happyMediumStl/SparrowAprs/README.md

# SparrowAprs
An open source APRS beacon designed for high altitude balloons

Code is a bit of a mess, and this is a work in progress, but it does sucessfully transmit APRS packets
