happyMediumStl/SparrowAprs/Hardware/README.md

#SparrowAprs Hardware

Controlled impedance traces designed for 4 layer stackup at Oshpark.
