happyMediumStl/SparrowAprs/Hardware/SparrowAprsArt.brd

## EAGLE design Hardware/SparrowAprsArt.brd (2018-09-21)

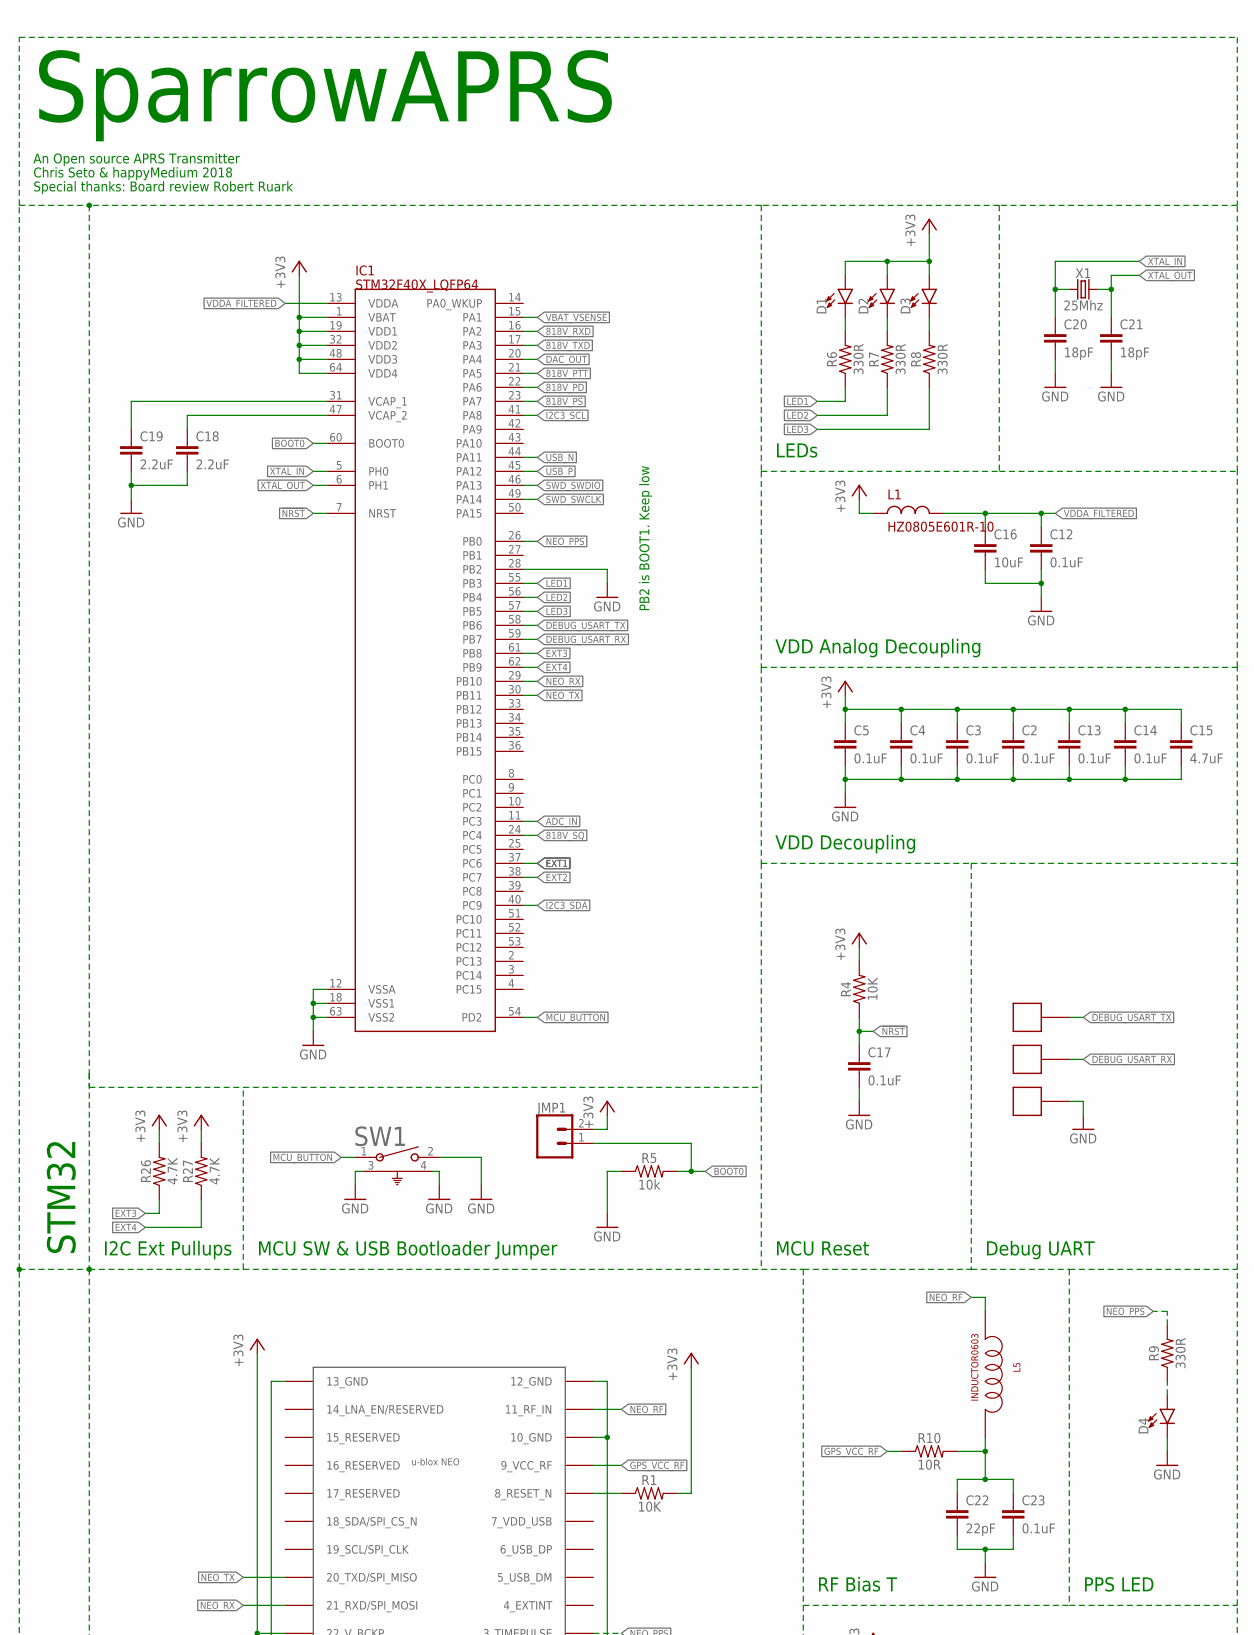
[picture p1: schematic SparrowAprsArt.sch, part in row 1, column 1]

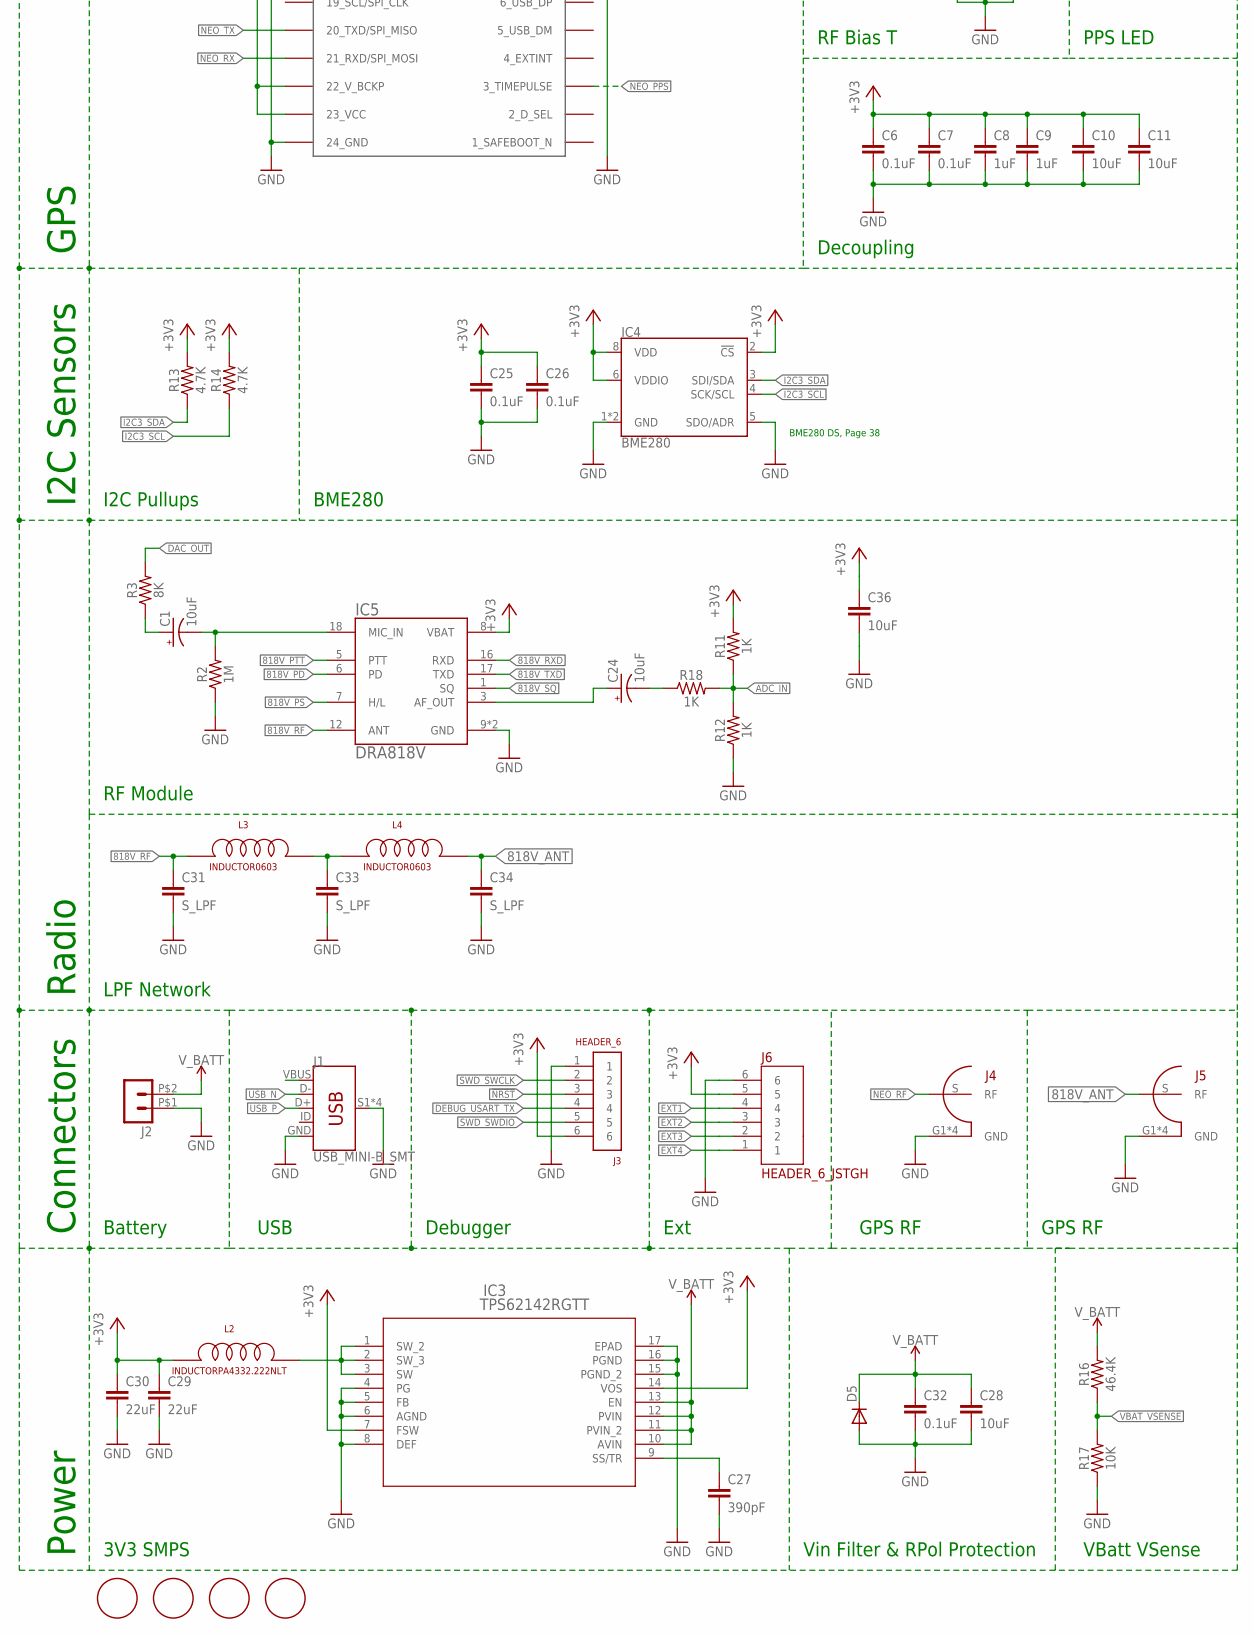
[picture p2: schematic SparrowAprsArt.sch, part in row 2, column 1]

Parts:
C1, C24: 10uF; 1206
C2, C3, C4, C5, C6, C7, C12, C13, C14, C17, C23, C25, C26, C32: 0.1uF; 0603
C8, C9: 1uF; C0805
C10, C11, C16, C28, C36: 10uF; C0805
C15: 4.7uF; C0805
C18, C19: 2.2uF; C0805
C20, C21: 18pF; 0603
C22: 22pF; 0603
C27: 390pF; 0603
C29, C30: 22uF; 1210
C31, C33, C34: S_LPF; 0603
D1, D2, D3, D4: LED0603; LED-0603
D5: DIODE-DO214AC; DO214AC
IC1: STM32F40X_LQFP64; STM32_LQFP64
IC2: NEO-M8
IC3: TPS62142RGTT; RGT16_1P7X1P7
IC4: BME280; LGA-8-2.5X2.5
IC5: DRA818V; DORJI_DRA818V
J1: USB_MINI-B_SMT; USB-MINIB
J2: HEADER_POS2_43650-0200; 43650-0200
J3: HEADER_6; 6X2_SMT
J4, J5: FSK_RUARK2_SMA_0732511150; FSK_RUARK2_WIDE_SMA
J6: HEADER_6_JSTGH; BM06B-GHS-TBT(LF)(SN)(N)
JMP1: CONN_02; 1X02
L1: HZ0805E601R-10; R0805
L2: INDUCTORPA4332.222NLT; PA4332.222NLT
L3, L4, L5: INDUCTOR0603; 0603
R1, R4, R17: 10K; 0603
R2: 1M; 0603
R3: 8K; 0603
R5: 10k; 0603
R6, R7, R8, R9: 330R; 0603
R10: 10R; 0603
R11, R12, R18: 1K; 0603
R13, R14, R26, R27: 4.7K; 0603
R16: 46.4K; 0603
SW1: 1825027-8; SW2_1825027-C
U$2, U$3, U$4: SINGLEPADMIDPAD; MIDPAD
U$7, U$8, U$9, U$10: MOUNTING_HOLE#2; #2_CLEARANCE_HOLE
X1: 25Mhz; CRYSTAL-SMD-3.2X2.5MM

Connections:
818V_ANT: C34.1, J5.S (RF), L4.2
818V_PD: IC1.22 (PA6), IC5.6 (PD)
818V_PS: IC1.23 (PA7), IC5.7 (H/L)
818V_PTT: IC1.21 (PA5), IC5.5 (PTT)
818V_RF: C31.1, IC5.12 (ANT), L3.1
818V_RXD: IC1.16 (PA2), IC5.16 (RXD)
818V_SQ: IC1.24 (PC4), IC5.1 (SQ)
818V_TXD: IC1.17 (PA3), IC5.17 (TXD)
!NRST: C17.1, IC1.7 (NRST), J3.3, R4.1
+3V3: C2.1, C3.1, C4.1, C5.1, C6.1, C7.1, C8.1, C9.1, C10.1, C11.1, C13.1, C14.1, C15.1, C25.1, C26.1, C29.1, C30.1, C36.1, D1.A, D2.A, D3.A, IC1.1 (VBAT), IC1.19 (VDD1), IC1.32 (VDD2), IC1.48 (VDD3), IC1.64 (VDD4), IC2.22 (22_V_BCKP), IC2.23 (23_VCC), IC3.7 (FSW), IC3.14 (VOS), IC4.2 (!CS), IC4.6 (VDDIO), IC4.8 (VDD), IC5.8 (VBAT), J3.6, J6.5, JMP1.2, L1.1, L2.1, R1.2, R4.2, R11.2, R13.2, R14.2, R26.2, R27.2
ADC_IN: IC1.11 (PC3), R11.1, R12.2, R18.2
BOOT0: IC1.60 (BOOT0), JMP1.1, R5.2
DAC_OUT: IC1.20 (PA4), R3.2
DEBUG_USART_RX: IC1.59 (PB7), U$3.1
DEBUG_USART_TX: IC1.58 (PB6), J3.4, U$2.1
EXT1: IC1.37 (PC6), J6.4
EXT2: IC1.38 (PC7), J6.3
EXT3: IC1.61 (PB8), J6.2, R26.1
EXT4: IC1.62 (PB9), J6.1, R27.1
GND: C2.2, C3.2, C4.2, C5.2, C6.2, C7.2, C8.2, C9.2, C10.2, C11.2, C12.2, C13.2, C14.2, C15.2, C16.2, C17.2, C18.2, C19.2, C20.2, C21.2, C22.2, C23.2, C25.2, C26.2, C27.2, C28.2, C29.2, C30.2, C31.2, C32.2, C33.2, C34.2, C36.2, D4.C, D5.A, IC1.12 (VSSA), IC1.18 (VSS1), IC1.28 (PB2), IC1.63 (VSS2), IC2.10 (10_GND), IC2.12 (12_GND), IC2.13 (13_GND), IC2.24 (24_GND), IC3.4 (PG), IC3.5 (FB), IC3.6 (AGND), IC3.8 (DEF), IC3.15 (PGND_2), IC3.16 (PGND), IC3.17 (EPAD), IC4.1 (GND), IC4.5 (SDO/ADR), IC4.7 (GND), IC5.9 (GND), IC5.10 (GND), J1.GND, J1.S1 (SHIELD), J1.S2 (SHIELD), J1.S3 (SHIELD), J1.S4 (SHIELD), J2.P$1 (1), J3.1, J4.G1 (GND), J4.G2 (GND), J4.G3 (GND), J4.G4 (GND), J5.G1 (GND), J5.G2 (GND), J5.G3 (GND), J5.G4 (GND), J6.6, R2.1, R5.1, R12.1, R17.1, SW1.2, SW1.3, SW1.4, U$4.1
GPS_VCC_RF: IC2.9 (9_VCC_RF), R10.1
I2C3_SCL: IC1.41 (PA8), IC4.4 (SCK/SCL), R14.1
I2C3_SDA: IC1.40 (PC9), IC4.3 (SDI/SDA), R13.1
LED1: IC1.55 (PB3), R6.1
LED2: IC1.56 (PB4), R7.1
LED3: IC1.57 (PB5), R8.1
MCU_BUTTON: IC1.54 (PD2), SW1.1
unnamed: C19.1, IC1.31 (VCAP_1)
unnamed: C18.1, IC1.47 (VCAP_2)
unnamed: IC2.8 (8_RESET_N), R1.1
unnamed: D2.C, R7.2
unnamed: D3.C, R8.2
unnamed: D1.C, R6.2
unnamed: C22.1, C23.1, L5.2, R10.2
unnamed: D4.A, R9.1
unnamed: C1.1 (+), R3.1
unnamed: C24.2 (-), R18.1
unnamed: C1.2 (-), IC5.18 (MIC_IN), R2.2
unnamed: C33.1, L3.2, L4.1
unnamed: IC3.1 (SW_2), IC3.2 (SW_3), IC3.3 (SW), L2.2
unnamed: C24.1 (+), IC5.3 (AF_OUT)
unnamed: C27.1, IC3.9 (SS/TR)
NEO_PPS: IC1.26 (PB0), IC2.3 (3_TIMEPULSE), R9.2
NEO_RF: IC2.11 (11_RF_IN), J4.S (RF), L5.1
NEO_RX: IC1.29 (PB10), IC2.21 (21_RXD/SPI_MOSI)
NEO_TX: IC1.30 (PB11), IC2.20 (20_TXD/SPI_MISO)
SWD_SWCLK: IC1.49 (PA14), J3.2
SWD_SWDIO: IC1.46 (PA13), J3.5
USB_N: IC1.44 (PA11), J1.D-
USB_P: IC1.45 (PA12), J1.D+
VBAT_VSENSE: IC1.15 (PA1), R16.1, R17.2
VDDA_FILTERED: C12.1, C16.1, IC1.13 (VDDA), L1.2
V_BATT: C28.1, C32.1, D5.C, IC3.10 (AVIN), IC3.11 (PVIN_2), IC3.12 (PVIN), IC3.13 (EN), J2.P$2 (2), R16.2
XTAL_IN: C20.1, IC1.5 (PH0), X1.1
XTAL_OUT: C21.1, IC1.6 (PH1), X1.3 (2)

Notes on the sheet:
GPS
Radio
I2C Sensors
Battery
Connectors
STM32
Decoupling
RF Bias T
BME280 DS, Page 38
Power
PPS LED
VBatt VSense
I2C Pullups
BME280
VDD Decoupling
MCU Reset
Debug UART
VDD Analog Decoupling
LEDs
Debugger
GPS RF
USB
3V3 SMPS
I2C Ext Pullups
MCU SW & USB Bootloader Jumper
RF Module
LPF Network
Vin Filter & RPol Protection
PB2 is BOOT1. Keep low
Ext
SparrowAPRS
An Open source APRS Transmitter
Chris Seto & happyMedium 2018
Special thanks: Board review Robert Ruark

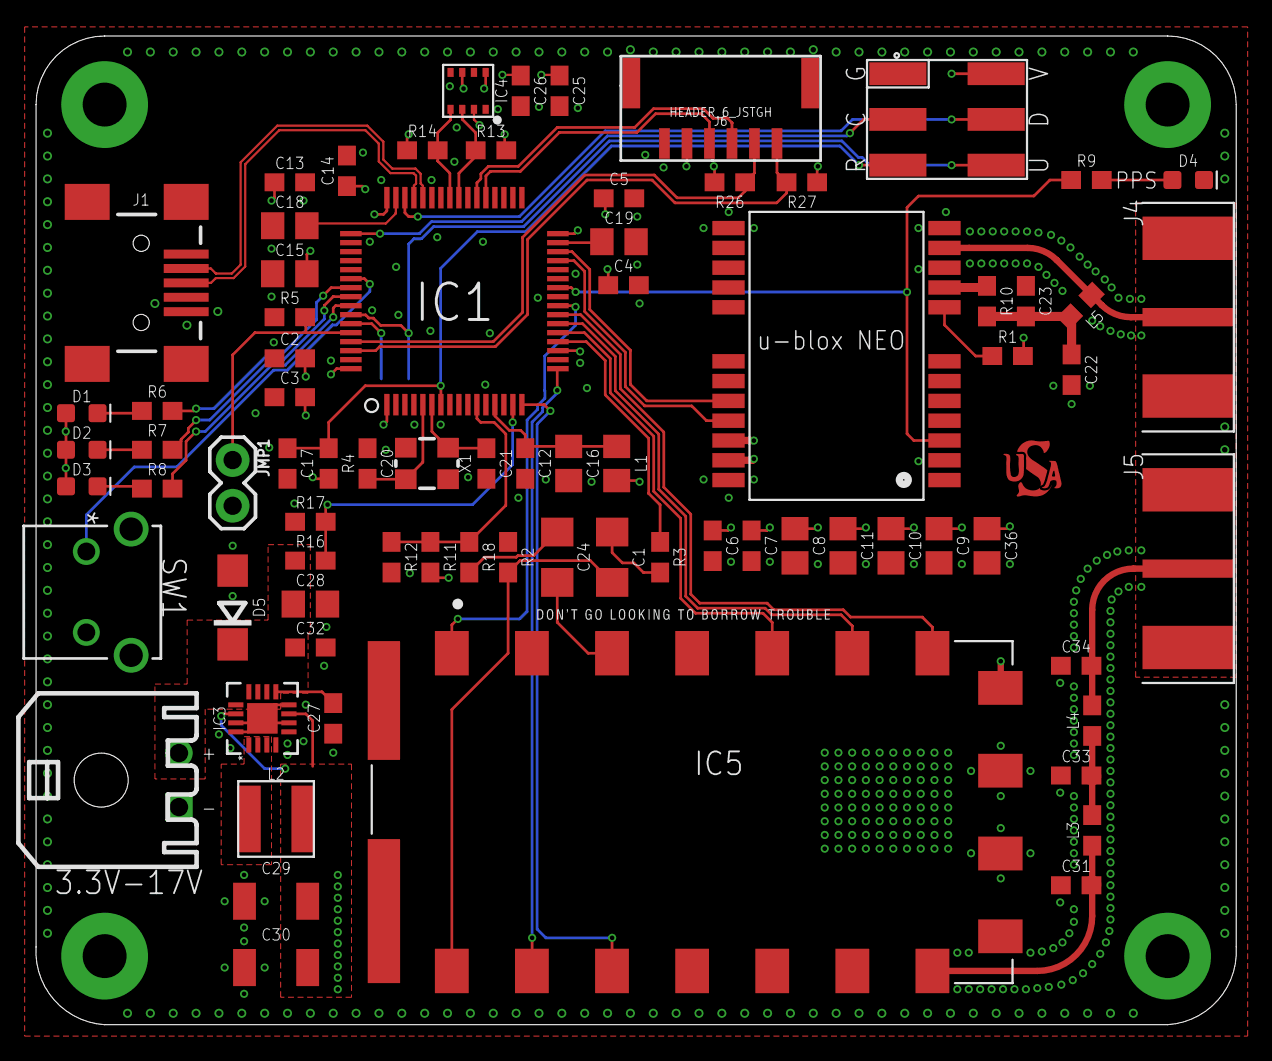
[picture p3: board SparrowAprsArt.brd from above]

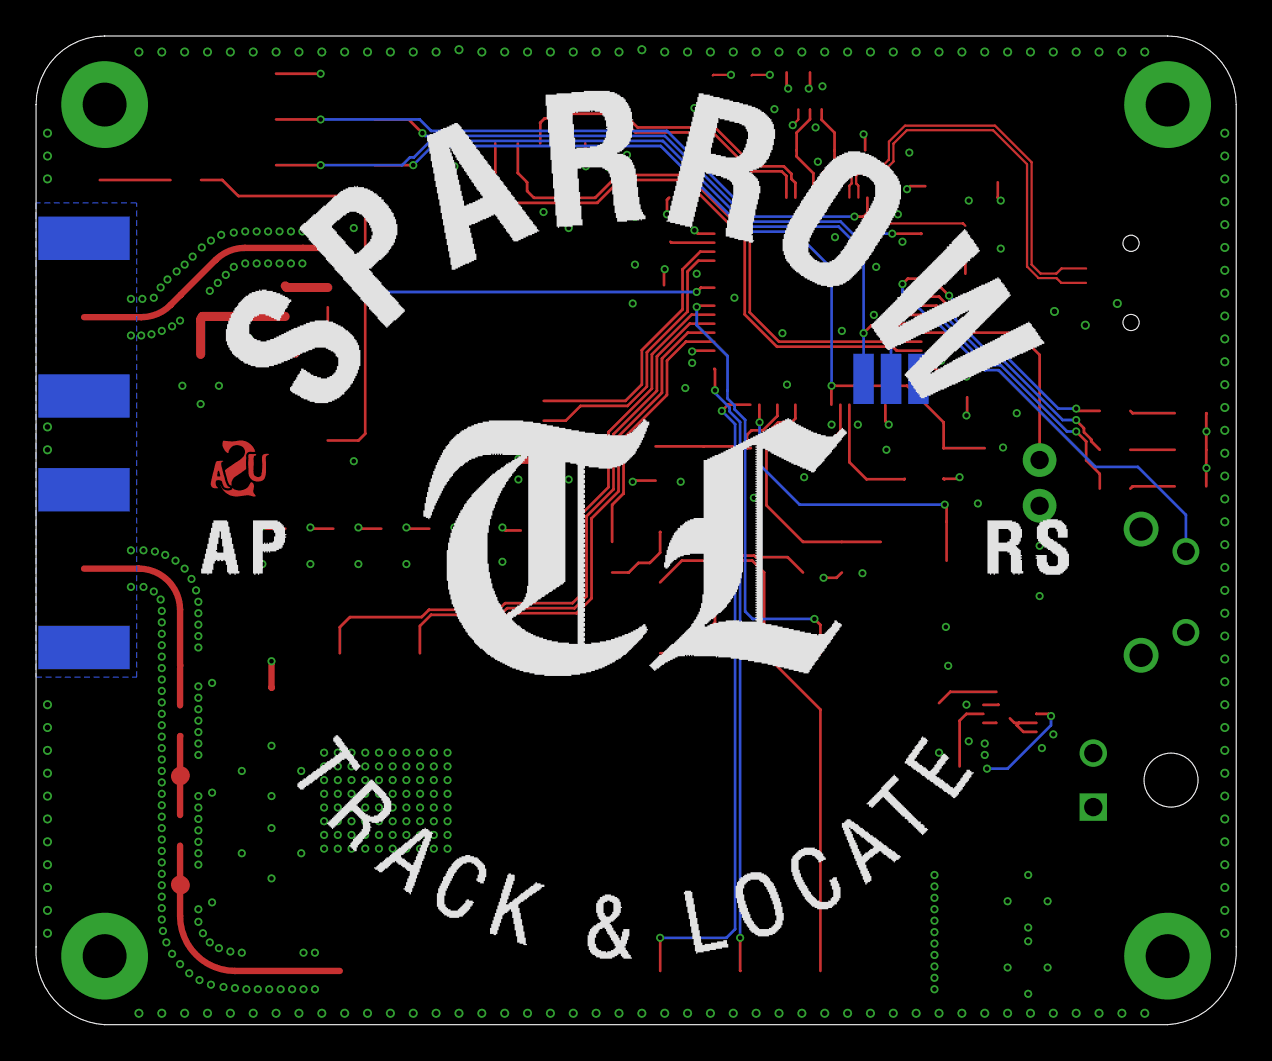
[picture p4: board SparrowAprsArt.brd from below]

Board: 4 copper layers, 66.7 x 54.9 mm, 85 parts (3 on the bottom side), 55 nets.
