happyMediumStl/SparrowAprs/Software/SparrowAprs/SparrowAprs/Main.c

/*
	OZARK SPRING
		-- A Simple APRS encoder
		-- Chris Seto, 2018

	Special thanks:
		* Rob Ruark
		* Sterling Coffey

	APRS/Bell 202/AX25 Resources:
		* http://chapmanworld.com/2015/04/07/arduino-uno-and-fast-pwm-for-afsk1200/
		* https://hugosprojects.wordpress.com/2014/03/15/implementing-aprs/
		* https://hugosprojects.wordpress.com/2014/03/20/implementing-aprs-gps-data/
		* https://hugosprojects.wordpress.com/2014/03/25/implementing-aprs-message-at-the-bit-level/
		* http://tt7hab.blogspot.com/2017/02/aprs-automatic-packet-reporting-system.html
		* https://github.com/TomasTT7/TT7F-Float-Tracker/blob/master/Software/ARM_APRS.c
*/

#include <stm32f4xx_hal.h>
#include "FreeRTOS.h"
#include "task.h"
#include "FreeRTOSConfig.h"
#include "Retarget.h"
#include "Audio.h"
#include "Dra818Io.h"
#include "Dra818.h"
#include "Beacon.h"
#include "Led.h"
#include "Nmea0183.h"
#include "Rtc.h"
#include "Radio.h"
#include "Bsp.h"
#include "FlashConfig.h"
#include "Watchdog.h"
#include "Bme280Shim.h"
#include "UbloxNeo.h"
#include "Usb.h"
#include "GpsHub.h"

static void SystemClock_Config(void);
void SystemIdle(void * pvParameters);

#define SYSTEM_IDLE_DELAY	100
static TaskHandle_t idleTaskHandle = NULL;

int main(void)
{
	// Init HAL
	HAL_Init();
	
	// LED init
	LedInit();

	// Configure clock
	SystemClock_Config();

	LedOn(LED_1);

	// Init watchdog
	//WatchdogInit();
	WatchdogFeed();
	
	// Init retarget
	RetargetInit();
	printf("%cBoard up!\r\n", 12);

	// Verify clocks
	if (HAL_RCC_GetHCLKFreq() != 168000000)
	{
		printf("Warning: sysClock freq does not match\r\n");
	}

	// Init config
	WatchdogFeed();
	FlashConfigInit();
	
	// BSP init
	BspInit();

	// RTC
	WatchdogFeed();
	RtcInit();

	// Init BME280
	WatchdogFeed();
	Bme280ShimInit();

	// Init USB
	UsbInit();

	// Init DRA818
	Dra818IoInit();
	WatchdogFeed();
	Dra818Init();
	
	// Init beacon
	BeaconInit();

	// Init Audio Out
	AudioInit();
	
	// Init NMEA
	WatchdogFeed();
	Nmea0183Init();
	
	// Init GPS Hub
	GpsHubInit();

	// Init radio
	WatchdogFeed();
	RadioInit();

	// Start system idle
	xTaskCreate(SystemIdle,
		"SystemIdle",
		128,
		NULL,
		tskIDLE_PRIORITY,
		&idleTaskHandle);

	// Start nmea parser
	Nmea0183StartParser();
	
	// Start GPS hub
	GpsHubStartTask();
	
	// Start radio task
	RadioTaskStart();

	// Start beaconing
	BeaconStartTask();

	// Start RTOS kernal
	vTaskStartScheduler();

	// Do nothing
	while(1);
}

// Crash handler due to a stack overflow
void vApplicationStackOverflowHook(xTaskHandle *pxTask, signed char *pcTaskName)
{
	printf("Crash!\r\n");

	while (1)
	{
	}
}

// System Idle task
void SystemIdle(void * pvParameters)
{
	while (1)
	{
		// Feed watchdog
		WatchdogFeed();

		// Blink LED
		LedToggle(LED_1);

		// Wait
		vTaskDelay(SYSTEM_IDLE_DELAY / portTICK_PERIOD_MS);
	}
}


// Handle systick
void SysTick_Handler(void)
{
	HAL_IncTick();

	if (xTaskGetSchedulerState() != taskSCHEDULER_NOT_STARTED)
	{ 
		xPortSysTickHandler();
	}
}

// Configure clock system
static void SystemClock_Config(void)
{
	RCC_ClkInitTypeDef RCC_ClkInitStruct;
	RCC_OscInitTypeDef RCC_OscInitStruct;
	RCC_PeriphCLKInitTypeDef PeriphClkInitStruct;

	// Enable clocks
	__HAL_RCC_PWR_CLK_ENABLE();
  
	/* The voltage scaling allows optimizing the power consumption when the device is 
	   clocked below the maximum system frequency, to update the voltage scaling value 
	   regarding system frequency refer to product datasheet.  */
	__HAL_PWR_VOLTAGESCALING_CONFIG(PWR_REGULATOR_VOLTAGE_SCALE1);
  
	// HSE feeds PLL
	RCC_OscInitStruct.OscillatorType		= RCC_OSCILLATORTYPE_HSE;
	RCC_OscInitStruct.HSEState				= RCC_HSE_ON;
	RCC_OscInitStruct.PLL.PLLState			= RCC_PLL_ON;
	RCC_OscInitStruct.PLL.PLLSource			= RCC_PLLSOURCE_HSE;
	RCC_OscInitStruct.PLL.PLLM				= 25;
	RCC_OscInitStruct.PLL.PLLN				= 336;
	RCC_OscInitStruct.PLL.PLLP				= RCC_PLLP_DIV2;
	RCC_OscInitStruct.PLL.PLLQ				= 7;
	
	if (HAL_RCC_OscConfig(&RCC_OscInitStruct) != HAL_OK)
	{
		while (1)
		{
		}
	}

	// Select PLL as system clock source and configure the HCLK, PCLK1 and PCLK2 clocks dividers
	RCC_ClkInitStruct.ClockType				= (RCC_CLOCKTYPE_SYSCLK | RCC_CLOCKTYPE_HCLK | RCC_CLOCKTYPE_PCLK1 | RCC_CLOCKTYPE_PCLK2);
	RCC_ClkInitStruct.SYSCLKSource			= RCC_SYSCLKSOURCE_PLLCLK;
	RCC_ClkInitStruct.AHBCLKDivider			= RCC_SYSCLK_DIV1;
	RCC_ClkInitStruct.APB1CLKDivider		= RCC_HCLK_DIV4;  
	RCC_ClkInitStruct.APB2CLKDivider		= RCC_HCLK_DIV2;
	
	if (HAL_RCC_ClockConfig(&RCC_ClkInitStruct, FLASH_LATENCY_5) != HAL_OK)
	{
		while (1)
		{
		}
	}

	// Enable LSI for watchdog
	RCC_OscInitStruct.OscillatorType = RCC_OSCILLATORTYPE_LSI | RCC_OSCILLATORTYPE_LSE;
	RCC_OscInitStruct.PLL.PLLState   = RCC_PLL_NONE;
	RCC_OscInitStruct.LSEState       = RCC_LSE_OFF;
	RCC_OscInitStruct.LSIState       = RCC_LSI_ON;

	if (HAL_RCC_OscConfig(&RCC_OscInitStruct) != HAL_OK)
	{
		while (1)
		{
		}
	}

	// Connect HSE/25 to RTC
	PeriphClkInitStruct.PeriphClockSelection = RCC_PERIPHCLK_RTC;
	PeriphClkInitStruct.RTCClockSelection = RCC_RTCCLKSOURCE_HSE_DIV25;
	HAL_RCCEx_PeriphCLKConfig(&PeriphClkInitStruct);

	// STM32F405x/407x/415x/417x Revision Z devices: prefetch is supported
	if (HAL_GetREVID() == 0x1001)
	{
		// Enable flash prefetch
		__HAL_FLASH_PREFETCH_BUFFER_ENABLE();
	}
}
