happyMediumStl/SparrowAprs/(commit log)

2018-08-13 Added hardware
    [SparrowAprs.brd, SparrowAprs.sch]
2018-08-13 Added BOM
    [SparrowAprsBom.csv]
2018-08-14 Code cleanup, added BSP vSense, fixed filters, added flash config
    [Beacon.c, Bsp.c, Config.c, Config.h, FlashConfig.c, FlashConfig.h, Main.c]
2018-09-07 New hardware rev
    [SparrowAprs.brd, SparrowAprs.sch]
2018-09-21 Updated hardware
    [SparrowAprs.brd, SparrowAprsArt.brd, SparrowAprsArt.sch]
2018-10-12 Dev snapshot: APRS message tx now works, DRA818V configuration string fix
    [Audio.c, Ax25.c, Beacon.c, Dra818.c, Fallback.c, GpsHub.c, Helpers.c, Helpers.h]
